dspl1236/CerberusCAN/(commit log)

2026-06-10 Initial scaffold: Cerberus — Teensy 4.1 tri-CAN OBD interface for VAG
    MVP firmware (Head 1 @ 500k ISO-TP/UDS bridge over USB serial), three-heads design + OBD pinout + HS/FT transceiver guidance, PlatformIO build + CI, and a host probe that runs the cross-module 0x00BE read (Experiment 1). Heads 2/3 stubbed.
2026-06-10 Solidify firmware: multi-frame ISO-TP writes, Head 2 @ 100k, sniff mode
    - isotp_send: full multi-frame TX (first frame + flow control + consecutive
    frames, honoring block size / STmin) so UDS writes like 2E00BE (37 bytes) and
    2E04A3 work, not just <=7-byte single-frame requests
    - bring up Head 2 (CAN2 @ 100k) alongside Head 1
    - SNIFF:<bus>:<ms> passive monitor to capture the CP handshake
    - UDS:<bus>:... explicit bus routing; INFO/PING; bare TX:RX:HEX still = Head 1
    - templated ISO-TP so one code path serves both classic buses
    - docs: SN65HVD230 dual-board reality, 3.3V/USB power, CTX/CRX direction,
    conditional Head-2 transceiver (HS SN65HVD230 vs FT TJA1055T/3), CAN-FD note
    Co-Authore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
2026-06-10 docs: commit both heads to SN65HVD230
    Head 2 FT / TJA1055T-3 case demoted from a pre-purchase decision to an if-Head-2-sniffs-nothing diagnostic note. README + HARDWARE + config.h.
2026-06-11 host: add cerberus_sniff.py + cerberus_write.py
    Sniffer: passive SNIFF capture, live dump + per-ID summary; an empty comfort bus is flagged as the fault-tolerant tell. Writer: generic read-before -> confirm -> 2E -> read-back verify UDS driver with --dry-run; not a hard-coded CP recipe. README lists all three host scripts.
2026-06-12 brand: add CerberusCAN logo/avatar/favicon + light/dark README banner
    Three Cerberus heads tapping a twisted pair (CAN-H crimson / CAN-L charcoal) with bus terminators. Assets under docs/brand/: master SVG (dark-mode aware), logo light+dark PNG, hexagon avatar (svg + 64/256/512), simplified favicon (svg + 32/64, wire dropped for small sizes). README header now uses a prefers-color-scheme <picture> banner; dark variant lightens wire/terminators to #9DA7B0 for contrast. Includes a brand guide (palette + usage) in docs/brand/README.md.
2026-06-13 docs: build guide + pre-built firmware hex; banner reflects on-car validation
    Add docs/BUILD.md (BOM, wiring, flash via Teensy Loader hex OR PlatformIO, bring-up, and real-world troubleshooting from first-light on a 2013 A6 C7 - incl. the clone-board CTX/CRX mislabel that yields INFO/PING-ok-but-0-frames). Publish firmware/cerberus-can-v0.2.0-teensy41.hex (gitignore exception for firmware/*.hex). README banner now says hardware-validated on a real car; Quick start offers both flash paths + links BUILD.md. HARDWARE: strengthen the CTX/CRX swap gotcha with the on-car symptom set.
2026-06-13 docs: Head 2 / OBD 3-11 is car-dependent (gateway firewall) - honest + forward-looking
    Pins 3/11 are OEM-discretion: some VAG/Porsche models route a 2nd CAN there, but many gateway cars (incl. the C7 A6) firewall the OBD port to the diagnostic CAN only, so 3/11 is dead and Head 2 reads nothing (Ross-Tech: OBD CAN is a dedicated diagnostic bus separated from internal buses by the gateway). README/HARDWARE/example-scan now frame Head 2 as conditional with a meter-3/11 decision tree (HS=works, FT=TJA1055T/3, dead=tap an internal bus). Keeps Head 2 valid for cars that DO expose 3/11; documents the C7 finding as the example.
2026-06-17 feat(fw): v0.3.1-tp — UDS over ISO-TP (flow control) + line protocol
    Firmware brought up to the working v0.3.1-tp that the host tools target:
    - full UDS exchange on Head 1/2 (single + multi-frame, with flow control) via
    UDS:<bus>:<TX>:<RX>:<HEX> and the TXID:RXID:HEX shorthand -> OK:<resp>
    - SNIFF:<bus>:<ms> passive dump (ms=0 = until any byte), SCAN TesterPresent sweep,
    RAW one-frame send, TP background TesterPresent keep-alive, PING/INFO
    - diagnostic ERR codes (tx-fail / no-flow-control / no-response / partial)
    - UDS_TIMEOUT_MS 1500 -> 6000 (VAG gateways take ~5 s on CP DIDs like 0x00BE)
    [cerberus_config.h, main.cpp]
2026-06-17 feat(host): live-view sniffer + ISO-TP/VW TP 2.0 decoder
    - cerberus_sniff.py: live running frame counter + run-until-Ctrl-C (ms=0), every
    frame flushed to CSV as it arrives, -v firehose option, robust buffered reader.
    - cerberus_decode.py (NEW): reassemble a capture over BOTH ISO-TP and VW TP 2.0,
    label UDS/KWP services, flag the CP-relevant ones (TrainICA / 0x00BE / 0x27).
    (The Simos-Suite repo carries an integrated twin at cp_tools/can_decode.py.)
2026-06-17 docs(host): add a VIN-free sample_capture.csv to try the decoder without hardware
    128 frames sliced from a real Audi C7 capture, covering three transactions across
    both transports so cerberus_decode.py can be tried with no board:
    - J533 gateway constellation/slot read (ISO-TP, 710/77A)
    - J255 HVAC identity (EV_AirCondiBasisUDS) (ISO-TP, 746/7B0)
    - J136 seat identity over VW TP 2.0 (200/226 setup -> 300/4C6 data)
    Engine 7E0/7E8 frames (which carry the VIN) are excluded; an assert verifies no VIN
    bytes remain. Run: python host/cerberus_decode.py host/sample_capture.csv
    [sample_capture.csv]
2026-06-17 fw 0.4.0: listen-only sniff (VCI-drop fix) + ID filter + STATS + SLCAN (#3)
    * feat(fw): listen-only SNIFF (LOM) + ID filter + STATS [v0.4.0]
    - SNIFF now runs the controller in hardware LISTEN-ONLY (setBaudRate(baud, LISTEN_ONLY))
    for the duration of the sniff, restoring TX after — so it never ACKs and can't knock a
    tester (ODIS/VAS6154) off a shared bus. Fixes VCI drops while sniffing.
    - SNIFF:<bus>:<ms>[:idlo:idhi] — optional software ID accept-range to cut volume/noise and
    focus on CP traffic; DONE: now reports an `overrun:` count (dropped-frame hint).
    - STATS:<bus> — CAN error counters / fault-confinement state / ACK-CRC-FRM-STF flags
    (FlexCAN_T4 error()), to diagnose bus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
    [cerberus_config.h, main.cpp]
2026-06-17 fw v0.5.0: CANX primitive + TC1796 CAN-BSL Tier-1 toolset (Simos8.x bench read/write) (#4)
    Adds the path to bench-read/write the Simos 8.5 engine ECU (TC1796/AudoNG, e.g.
    Audi C7 3.0T 4G0907551x), which can't be programmed over in-car OBD.
    Firmware (v0.5.0-canx):
    CANX:bus:ID:HEX[:waitms] — send one classic frame in TX mode then listen waitms.
    The send-then-listen primitive SNIFF (listen-only) and RAW (send-only) lacked;
    lets the host drive low-level request/response protocols (the TC1796 CAN BSL)
    with no per-tweak reflash. Compiles clean for teensy41.
    Host (host/tc1796_bsl.py):
    Clean reimplementation of fastboatster/TC1796_CAN_BSL's Tier-1 path over Cerberus
    serial instead of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
2026-06-17 feat(fw): v0.6.0 — Head 2 always-on listen-only logger (MON), dual-head capture (#5)
    Turns Cerberus into a dual-head capture box: Head 1 stays the active VCI (UDS
    read/write/CP), and Head 2 — a SECOND SN65HVD230 tapped in parallel on OBD 6/14,
    held LISTEN_ONLY — becomes an always-on background logger. So you can DRIVE an
    active UDS/CP exchange on Head 1 and capture the unmasked wire on Head 2 at the
    same time, from one box (the whole point for capturing the CP handshake live).
    - BUS2_BAUD 100000 -> 500000; Head 2 set LISTEN_ONLY at boot (2nd tap on the diag bus).
    - New `MON:on[:idlo:idhi] | MON:off`: streams every Head-2 frame as M2:<ms>:<id>:<hex>[:OVR],
    interleaved with command re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
2026-06-18 feat(fw): v0.7.0 — ring-buffered MON logger (lossless capture under load) (#6)
    The Head-2 background logger no longer prints straight to USB (which blocked when the
    host couldn't drain, overflowing the 256-deep FlexCAN FIFO and dropping frames). Capture
    is now decoupled by a 16384-frame / 256 KB ring buffer in OCRAM (DMAMEM):
    - mon_capture() drains the FIFO into the ring — fast, never blocks (the anti-drop guarantee).
    - mon_flush() drains the ring to USB only when there's TX room — never blocks.
    - Both run in loop() AND inside the ISO-TP wait loops, so a USB stall or a long blocking
    Head-1 transaction no longer costs frames; the ring absorbs the burst and drains after.
    - If the ring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
    [cerberus_config.h, main.cpp]
2026-06-18 feat(fw): v0.8.0 — optional SSD1306 OLED status HUD (auto-detected) (#7)
    A little on-board HUD so you can eyeball Cerberus mid-capture without a laptop. When a
    MON session is live it shows total / frames-per-sec / dropped / peak; otherwise idle +
    head roles. Throttled to ~4 Hz (I2C is blocking) — never per-loop, so it can't disturb
    the MON pump or an active transaction.
    - I2C0 (pin 18 SDA / 19 SCL) @ 0x3C, SSD1306Ascii (text-only, light). Default 128x32
    (the common 0.91/0.92"); #define OLED_128x64 for a 0.96".
    - AUTO-DETECTED: the probe NAKs if no panel is wired and every OLED line is skipped, so
    the firmware runs identically with or without the display (one binary for both).
    - Adds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
    [cerberus_config.h, main.cpp]
2026-06-18 fix(fw): v0.8.1 — OLED default 128x64 + dual-address probe + yellow-band title (#8)
    Matches the common 0.96" two-colour panels (e.g. GeeekPi 128x64 yellow/blue) the user
    actually has 20+ of:
    - Default geometry -> 128x64 (was 128x32). The yellow/blue split (16 px yellow + 48 px blue
    = 64 rows) confirms it's a 128x64; the reviewer's "0x3C is a 128x32 address" conflated the
    I2C address with resolution — 0x3C is just the standard SSD1306 address for both. Adafruit's
    128x64 example @ 0x3C is the correct config.
    - Probe 0x3C then 0x3D (some boards jumper to 0x3D; many silk-print 0x78 = the 8-bit form of
    0x3C). Still NAK-safe with no panel.
    - HUD laid out for 128x64: row 0 (yellow) = "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
    [cerberus_config.h, main.cpp]
2026-06-18 feat(fw): v0.8.2 — OLED per-head VU bars + live MODE title (#9)
    Makes the little screen show data in motion:
    - Title (yellow band) now reads "CERBERUS <MODE>" instead of the version — MODE flashes the
    last command (UDS / CANX / SCAN / RAW…) and settles to MON or IDLE. set_mode() is called per
    command in handleLine. (Version still in INFO, just not cluttering the HUD.)
    - Two auto-scaled VU bars replace the static "H1 VCI H2 LOG" line:
    H1 = our command/TX activity (h1_cmd, bumped per active command)
    H2 = bus traffic the logger sees (mon_total delta)
    Each peak rises instantly and decays slowly, so the bars "breathe" with the bus regardless
    of absolute rate — no magic c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
    [cerberus_config.h, main.cpp]
2026-06-18 docs: audit README to v0.8.2 — dual-head logger, full command set, BSL/SLCAN/OLED (#10)
    The README still described a v0.2.0 single-head + 100k-comfort-sniffer tool. Brought it
    current to the actual 0.8.2 request-level VCI:
    - Head 2 is now a 2nd SN65HVD230 on the SAME OBD 6/14 bus, LISTEN-ONLY = always-on logger
    (the old "Head 2 = 100k comfort CAN on 3/11" model was dropped in v0.6.0). Heads table +
    wiring updated; added the dual-tap wiring and the "remove both term resistors" note.
    - Command list completed: + STATS, TP, RAW, CANX, MON, SLCAN (was missing 6 commands).
    - New Features section: request-level UDS, dual-head ring-buffered lossless capture, SLCAN,
    TC1796 CAN-BSL Simos8 ben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
2026-06-18 v0.9.0 EMU responder mode + full docs audit (Head 2 -> 6/14, version-less hex) (#11)
    Firmware (v0.9.0-emu):
    - New EMU module-emulation responder (Head 1): answers UDS on a chosen REQ id from a RESP id
    by request-prefix rules (EMU:on:bus:REQ:RESP / EMU:add:PREFIX:RESP / clear / off / stat).
    Reassembles multi-frame requests (sends FC), sends multi-frame responses; unmatched -> 7F
    <sid> 11. Echoes EMURX:/EMUTX: to the host. Lets Cerberus pose as a fake module to probe how
    J533 / a tester reacts — the offensive CP angle. Runs the responder in loop() alongside MON.
    Compiles clean; EMU is dormant by default (emu_on=false) so 0.9.0 boots identically to 0.8.2.
    (Boot + EMU-on-the-wire n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
2026-06-18 v0.9.1: drop TC1796 CAN-BSL bench read/write support (#12)
    The TC1796 CAN bootstrap-loader read/write was a niche bench feature that never fit
    Cerberus's "OBD VCI" identity — pulled it to keep the tool focused.
    - Removed host/tc1796_bsl.py and docs/tc1796-bsl-cerberus-port.md (preserved in git history;
    could move to Simos-Suite later if wanted).
    - CANX stays — it's a general send-then-listen primitive, not BSL-specific; reworded its
    comment + the README/command note to drop the BSL framing.
    - Scrubbed BSL from README (feature bullet, host-scripts list, roadmap incl. the Tier-2 BSL
    item) and BUILD.md status/validated lines. INFO examples -> 0.9.1.
    Roadmap: that "older/odd cars" sl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
2026-06-18 docs(hardware): finalize K-line/KWP2000 design (USB-powered, no DC-DC) (#13)
    Records the settled design for the planned K-line interface (pre-CAN VAG, KWP2000 on OBD 7):
    - Teensy stays USB-powered -> NO DC-DC. Only the K-line transceiver's line side touches the
    car's 12 V (one wire from OBD 16 + the pull-up; the bus idles at battery voltage).
    - Two chip options: L9637D (5 V logic -> Vcc from VUSB + a level shifter, Teensy isn't 5V-tolerant)
    or MC33660 (3.3 V-capable logic -> straight to the UART, no shifter — the minimal-parts route).
    - Wiring: just OBD 7 (K-line) + OBD 16 (+12 V) beyond the CAN heads, + TX/RX to a spare UART.
    K-line is fewer bus wires than CAN (one, not a pair).
    - N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
2026-06-18 docs(hardware): K-line chip options — TJA1021/TJA1421 (3.3V VIO), rule out STN1110 (#14)
    Expands the K-line chip-choice list:
    - TJA1021 / TJA1421 (NXP LIN PHY): the VIO pin gives 3.3V-native logic -> straight to the UART,
    no level shifter. Cheap/available. Caveat: the LIN TXD-dominant timeout can kill the driver
    during ISO-9141 5-baud init (VAG uses it, incl. KW1281) — verify on the datasheet; bit-bang the
    init on a side GPIO/FET if needed. Fast-init (14230) cars unaffected.
    - MC33660: dedicated K-line, 3.3V logic, no dominant-timeout caveat — cleanest for old 5-baud VAG.
    - L9637D: classic dedicated K-line but 5V -> VUSB + level shifter.
    - STN1110 / ELM327-class interpreters expl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
2026-06-18 fw(0.9.2): HEAD2 active toggle + H2TEST self-test + SLCAN auto-enter fix (#15)
    Dual-head now hardware-validated on the live car (A6 C7): Head 1 active VCI +
    Head 2 both as a 2nd active VCI and as the listen-only MON logger (read VIN +
    gateway part on each head; MON captured Head-1 traffic, 0 dropped).
    - HEAD2:active|lom — flip Head 2 between a 2nd active VCI (UDS:2/RAW:2/CANX:2/
    SCAN:2 drive it) and the listen-only logger. Boot default = listen-only.
    - H2TEST — TX-path self-test: Head 1 listens (LISTEN_ONLY) while Head 2 transmits
    a marker frame; reports head1_saw + txerr. Splits a dead head into TX-path vs
    RX-path without a meter. (Key bring-up/QC tool for assembled units.)
    - SLC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
    [cerberus_config.h, main.cpp]
2026-06-18 fw(0.9.3): SELFTEST QC command + live-sniff GUI (#16)
    SELFTEST — one-command factory/bring-up check, no car needed:
    1) CAN1 internal loopback (controller core)
    2) CAN2 internal loopback (controller core)
    3) H1->H2 wire test: Head 1 transmits, Head 2 (LISTEN_ONLY) must hear it ->
    proves both transceivers + the shared CANH/CANL link + TX/RX orientation.
    Prints PASS/FAIL per check + "UNIT OK". Catches the exact crossed/dead-transceiver
    class of fault instantly. Verified on the bench-on-car: all three PASS.
    host/cerberus_sniff_gui.py — standalone tkinter live-sniff viewer (pyserial only):
    Connect -> sends MON:on -> streams Head 2's M2 frames into a live aggregated
    grid (I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
    [cerberus_config.h, cerberus_sniff_gui.py, main.cpp]
2026-06-18 CerberusCAN 0.9.6 — modes, firmware-flash tab, dual-target 4.0/4.1, single-exe app (#17)
    * fw(0.9.6): MODE + REBOOT + board-detect + self-contained SELFTEST + 4.0/4.1 targets
    - MODE:vci|sniff|dual — one-shot head posture (vci=active+logger, sniff=BOTH
    listen-only zero-footprint, dual=two active VCIs); steady OLED title reflects it.
    - INFO now reports board=T4.0/T4.1 (compile-time), so the host flashes the right hex.
    - REBOOT — jump to the HalfKay bootloader so the host can flash (Console Update).
    - SELFTEST: H1->H2 wire check now runs Head 2 in NORMAL mode so it ACKs Head 1
    itself -> self-contained (no external ACKer needed); clearer "needs a terminated
    bus + node" message when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
    [cerberus_config.h, cerberus_console.py, main.cpp]
2026-06-19 docs(readme): bring up to 0.9.6 — modes, Console app, 4.0/4.1, ODIS-CP capture (#18)
    - Status -> v0.9.6: dual-head hardware-validated on the A6 C7; logged a live ODIS
    Component-Protection session; builds for Teensy 4.0 AND 4.1; ships the desktop app.
    - New "Desktop app — CerberusConsole" section (Sniff / Diagnostics / Firmware tabs +
    single-.exe build).
    - Features: MODE (vci/sniff/dual, zero-footprint sniff), SELFTEST, REBOOT, 4.0/4.1.
    - Flash: one-click via the app + dual-target pio targets.
    - Host protocol: added MODE/HEAD2/H2TEST/SELFTEST/REBOOT + board= in INFO.
    - Host scripts: cerberus_console.py is the app to start with; sniff_gui superseded.
    - Roadmap: checked off modes/SELFTE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
2026-06-19 fw(0.9.7): Head 3 -> K-line / KWP2000 for pre-CAN VAG (bench-untested) (#19)
    K-line is a single-wire 12V UART bus (OBD pin 7), NOT CAN — so Head 3 moves off the
    CAN3 spare onto Serial2 (RX 7 / TX 8) through a K-line transceiver (TJA1021 et al).
    New `KWP` command:
    KWP:fast[:tgt] ISO 14230 fast init (25ms low/high -> StartCommunication 0x81)
    KWP:slow:<addr> 5-baud slow init (bit-bang the address @5 baud)
    KWP:<hex> framed request [0x80|len][tgt][F1][data][cksum] -> raw response (host parses)
    KWP:raw:<hex> send raw bytes, return raw response
    KWP:off close
    Half-duplex echo is swallowed on every send.
    Builds clean for both teensy40/teensy41. **BENCH-UN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
2026-06-19 fw(0.9.8): correct KWP2000 framing/init — validated against KWPBridge (#20)
    Cross-checked the bench-untested K-line driver against dspl1236/KWPBridge (tested on
    real cars) and fixed real bugs:
    - Frame format was wrong: used [0x80|len][tgt][F1][data][cks]; correct ISO 14230 is
    [0x80][tgt][0xF1][len][sid+data][cksum] — fmt is constant 0x80, length is a SEPARATE
    byte (not packed into the format byte).
    - Target address 0x10 -> 0x01 (engine ECU, per KWPBridge logical addressing).
    - Fast init: now the line-wiggle + 300ms sync wait only (no premature 0x81); the host
    sends the session itself (KWP:1089 for ME7 = startDiagnosticSession 0x89, or KWP:81).
    - Response now stripped to the payload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
    [cerberus_config.h, main.cpp]
2026-06-19 feat(host): DIDB + K-line DTC decode (Phase 0 of the KWPBridge port) (#21)
    Phase 0 of the KWPBridge -> Cerberus port (a deep multi-agent study of dspl1236/KWPBridge
    produced the plan). Pure host-side data + glue, no firmware footprint.
    - host/didb/ — the VAG Diagnostic Information Database ported verbatim from KWPBridge:
    dtc_descriptions.json (4,817 fault-location descriptions), modules.json (89 ECU
    addresses), and the stdlib-only lazy-singleton loader. + CREDITS.md (dealer-derived
    provenance; same data already public in KWPBridge).
    - host/kline_decode.py — fault_line()/fault_text()/vag_code()/module() over the DIDB.
    KEY DISTINCTION (verified in source): this decodes the **K-lin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
2026-06-19 feat(console): CANBUS/K-Line/Firmware pages + SAE J2012 DTC text (dual decode) (#22)
    Restructured the Console around Cerberus's heads (robust yet simple):
    - CANBUS (Heads 1-2): sub-tabs Sniff (passive logger + record) + Diagnostics (UDS:
    VIN/Part, Read/Clear DTCs) — DTCs now annotated with SAE J2012 English text.
    - K-Line (Head 3): KWP2000/KW1281 page — fast/5-baud init, session 10 89, Read ECU-ID,
    Read/Clear faults decoded via the VAG DIDB, per module address. Banner: needs the
    transceiver, bench-untested.
    - Firmware: unchanged (running vs bundled, one-click flash).
    Mode follows the active view (Sniff -> MODE:sniff; else MODE:vci); nested-notebook tab
    handling; everything preserve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
2026-06-19 fw(0.9.9): KWP baud param + KW1281 byte-engine; complete SAE DTC decode (FTB) (#23)
    Roadmap Phase 2 + 3 (firmware) + the FTB gap closed:
    - Phase 2: KWP K-line baud is now a runtime param (KWP:baud:<n>) — 10400 default, 9600
    for M232/AAN ECUs. Used by all K-line init paths.
    - Phase 3: KW1281 byte-engine (K81 cmd) — the OLD VAG block protocol for pre-CAN cars.
    Implemented fresh (NOT copied from KWPBridge, which stubs the ACK): 5-baud init +
    sync/keybyte handshake, the per-byte complement-ACK loop (must be on-Teensy — USB
    round-trip too slow), block framing [len][counter][title][data][0x03] with the shared
    auto-incrementing counter, ETX not acked. Verbs: K81:init/read/ack/block/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
    [cerberus_config.h, main.cpp, sae_decode.py]
2026-06-19 feat(console): K-Line page — KW1281 + live measuring blocks (roadmap Phase 4) (#24)
    Finishes the host side of the K-line roadmap:
    - Ported formula.py from KWPBridge (stdlib-only) — measuring-block cell scaling
    ([formula][A][B] -> RPM/°C/V/etc, raw fallback for unknown formula bytes).
    - K-Line page gains: a "Measuring group" reader (KWP2000 0x21 or KW1281 0x29 ->
    formula-decoded cells) and KW1281 Init / Read-block buttons (K81 verbs). Read-MB
    dispatches by the last-inited protocol (kwp vs kw1281).
    - Protocol tracked per init; KW1281 0xE7 measuring-value blocks decoded via the same
    formula path; faults still via the VAG DIDB.
    Implementable roadmap now complete (Phases 0-4); only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
2026-06-19 feat: product line — Orthrus (4.0) / Cerberus (4.1), one codebase (0.9.10) (#25)
    Names the two build targets as a product family (hounds of Typhon & Echidna):
    - Orthrus = Teensy 4.0, 2 heads (KWP + CAN) — compact, ~1995-2018 eras.
    - Cerberus = Teensy 4.1, 3 heads (KWP + CAN + DoIP) — flagship, every era.
    DoIP is the only differentiator and it's board-justified (the 4.0 has no Ethernet),
    so it's a compile flag (#if ARDUINO_TEENSY41), not a fork. ONE repo, one Console.
    - INFO now reports `product=Cerberus|Orthrus` (by board macro) alongside `board=`.
    - Console parses product= and titles itself accordingly ("Orthrus Console v0.9.10 —
    T4.0 fw 0.9.10"). One app serves both SKUs, in lo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
2026-06-19 feat(console): blank-board flash picker (4.0/4.1) for never-flashed Teensys (#26)
    A board that has run our firmware self-identifies via INFO (board=T4.0/T4.1) and
    flashes the correct hex with zero input — unchanged. The gap was a brand-new,
    never-flashed Teensy: 4.0 and 4.1 share the IMXRT1062 MCU and bootloader chip, so
    the model can't be auto-detected (and a blank board doesn't enumerate our serial,
    so you can't even "connect" to it).
    - Firmware tab now has a "Blank board" combobox, enabled ONLY when detection returns
    board=? (auto-detected boards keep it disabled — no way to mis-pick).
    - Flash gains a manual path: when undetected, use the picked model, skip the
    reboot-over-serial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
    [cerberus_console.py]
2026-06-19 docs: DoIP "sniff" = own-session pcap; + blank-board USB probe (#27)
    DoIP capture model decided. CAN sniff works because CAN is a shared bus; Ethernet
    is switched, so a single-PHY 4.1 can't passively hear a 3rd-party tester↔gateway
    session. The DoIP head's "sniff" is therefore own-session capture: as active tester
    or ECU emulator it logs its own frames to a .pcap (Wireshark DoIP dissector). An
    in-line DoIP tap (2 bridged interfaces / passive copper tap / SPAN, full-duplex
    wants 2 capture streams) is parked as a later external-hardware project.
    - docs/PRODUCT-LINE.md: new "DoIP capture" section + status note.
    - host/detect_teensy.py: pyserial USB-descriptor dump to empirically test whether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
2026-06-19 feat(host): DoIP (ISO 13400-2) capture decoder scaffold (#28)
    Offline-testable parser for the (unbuilt) DoIP head's own-session pcap capture:
    pcap -> peel Ethernet/IP/TCP-UDP -> filter port 13400 -> DoIP 8-byte header
    + payload -> hand UDS payloads to the existing CAN-side sae_decode.
    - Pure stdlib (no dpkt/Scapy) to keep the Console pyserial-only.
    - libpcap reader + writer (EN10MB, us/ns magic), IPv4 + VLAN peel.
    - ISO 13400-2 payload-type table; routing-activation, vehicle-announcement,
    and diagnostic-message (0x8001) decoders; diag pos/neg ack.
    - UDS (ISO 14229) SID + NRC names; DTCs reuse sae_decode (DoIP is just transport
    over the same UDS we decode for CAN — "branch by trans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
2026-06-19 docs: mark esp32 BLE bridge as archived/superseded in Related
2026-06-19 feat(fw): KWP:passthrough — transparent dumb-KKL-cable mode for NefMoto (0.9.11) (#30)
    NefMoto (and similar) want a transparent FTDI/CH340 K-line cable and own the
    KWP2000/KW1281 framing + init themselves; Cerberus's K-line head was the opposite
    (smart, firmware-framed). This adds a raw byte bridge so Cerberus can serve them.
    - `KWP:passthrough[:baud]` opens K-line at baud (10400 default) and enters a
    transparent loop: USB-serial <-> K-line, 1:1, no framing, no echo-suppression
    (the host sees the bus raw, like a real single-wire KKL cable). Reset to exit.
    - Bench-untested (no transceiver yet). Targets fast-init ECUs via NefMoto's generic
    COM-port path. KNOWN GAP: 5-baud slow-init /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
    [cerberus_config.h, cerberus_console.py, main.cpp]
2026-06-19 fix(console): PlatformIO upload fallback when teensy_loader_cli is absent (console 0.9.12)
    Running the .py from source has no teensy_loader_cli (it's only bundled into the
    .exe; PlatformIO ships teensy_post_compile, not the CLI). Flash now falls back to
    `platformio run -e teensyNN -t upload` from the repo root when the CLI isn't found,
    so the Flash button works from source. find_pio()/find_repo_root() added.
    [cerberus_console.py]
2026-06-19 ci: build CerberusConsole.exe on release tag, keep last 5 (#31)
    GitHub Actions (windows-latest): compiles teensy_loader_cli (native HID, no libusb)
    so the .exe ships a self-contained flasher, runs build_exe.bat (bundles both hexes +
    didb/saedb), and publishes the single-file exe as a Release.
    - Trigger: push a `console-v*` / `v*` tag, or the "Run workflow" button (releases the
    current CONSOLE_VERSION).
    - Retention: prunes to the newest KEEP_RELEASES (5) `console-v*` releases + their tags.
2026-06-19 ci: force CC=gcc for teensy_loader_cli (MINGW64 has ddk/hidsdi.h; bare cc=MSYS gcc lacks it)
2026-06-19 ci: tolerate teensy_loader_cli license filename variance
2026-06-19 feat: dual USB serial — always-dumb K-line KKL port for NefMoto (0.9.13) (#33)
    The board now enumerates as TWO CDC ports (USB_DUAL_SERIAL): the smart command/CAN
    port (our Console) + an always-transparent K-line cable on SerialUSB1. Tools that own
    the protocol (NefMoto, VCDS-dumb) just open the 2nd COM port — no mode to flip, no
    handoff, no replug. Realizes the "K-line dumb by default, smart available" design.
    Firmware:
    - platformio.ini: -D USB_DUAL_SERIAL.
    - kline_bridge(): raw SerialUSB1<->Serial2 pump, gated on the 2nd port being open (DTR);
    non-blocking writes (availableForWrite) so a slow K-line drain never stalls loop()/CAN.
    No buffer needed — K-line is ~10.4k half-duplex, U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
    [cerberus_config.h, cerberus_console.py, main.cpp]
2026-06-19 feat(fw): brand USB descriptor — CerberusCAN (4.1) / Orthrus (4.0) (0.9.14) (#34)
    Overrides the Teensy core's WEAK usb_string_product_name / usb_string_manufacturer_name
    with strong defs in src/usb_strings.c (PJRC's usb_names.h mechanism) — no framework
    edits, CI-safe, no global side effects. iProduct = CerberusCAN / Orthrus by board;
    iManufacturer = dspl1236. Verified both strings baked into the .elf.
    Scope note (honest): this sets the USB *descriptor* strings — shown by descriptor-aware
    tools (our Console/pyserial, USBView, IDE port menus, the "Bus reported device
    description" in Device Manager Details). The top-line Windows friendly name
    ("USB Serial Device (COMx)") is set by the i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
2026-06-19 fix(console): show raw K-line COM passively (no button/trigger) (console 0.9.15)
    The raw K-line port is transparent from power-on — there was never anything to 'trigger'.
    Replaced the 'Raw K-line port' button with an auto-updating label that just shows which
    COM is the dumb cable (the board's 2nd CDC, matched by USB serial) once connected. Point
    NefMoto there; no click, no mode to set.
    [cerberus_console.py]
2026-06-19 docs: accuracy audit — sync to 0.9.14/0.9.15 (dual-serial, NefMoto, MIT, CI releases)
    Brings the docs in line with the current state after this round of work:
    - README Status: v0.9.6 -> fw 0.9.14 / Console 0.9.15; adds dual-USB-serial (the
    always-dumb K-line port for NefMoto), the CI-built .exe on Releases, MIT; keeps the
    honest bench-untested / write-CP-experimental caveats.
    - README Console/Flash: the 2nd-COM NefMoto port, blank-board picker, PlatformIO-upload
    fallback, and "download the prebuilt .exe from Releases".
    - docs/BUILD.md: enumerates as TWO ports (product "CerberusCAN"/"Orthrus"); INFO example
    refreshed (0.9.14 + board=/product=/kline2=raw); GPLv3 footer -> MIT.
    - host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
2026-06-19 docs: accuracy audit — sync to 0.9.14/0.9.15 (dual-serial, NefMoto, MIT, CI releases)
2026-06-19 fix(console): probe-walk ports on connect — robust dual-serial port pick (0.9.16)
    The frozen .exe was landing on the raw K-line CDC and timing out: PyInstaller often
    blanks pyserial's serial_number, so the serial-number-based auto-hop never fired. Now
    connect PROBES — try a port, and if no INFO reply within its window, walk to the next
    Teensy (VID 0x16C0) port until one answers. No serial_number dependency; bounded by a
    tried-ports set so it can't ping-pong. _default_port + the raw-port label also fall back
    to VID matching.
    [cerberus_console.py]
2026-06-19 fix(console): probe-walk ports on connect — robust dual-serial port pick (0.9.16)
    The frozen .exe was landing on the raw K-line CDC and timing out: PyInstaller often blanks
    pyserial's serial_number, so the serial-number-based auto-hop never fired. Now connect PROBES:
    try a port, and if no INFO reply within its window, walk to the next Teensy (VID 0x16C0) port
    until one answers. No serial_number dependency; bounded by tried-ports so it can't ping-pong.
    _default_port + the raw-port label also fall back to VID matching.
2026-06-19 fix(console): synchronous INFO probe to pick the smart port (0.9.17)
    The 0.9.16 timed auto-hop still raced in the frozen exe — the 2.2s check fired before
    the async read-loop delivered INFO, so it bounced off the good Teensy port and walked
    all the way to COM1. Replaced it with a SYNCHRONOUS probe: _probe_port() opens a port,
    sends INFO, and reads directly for "CERBERUS:" (no async/queue timing). _connect_smart()
    probes the selected port first, then the other Teensy (VID 0x16C0) ports, and connects
    to the first that answers — deterministic, frozen-exe-safe. Removed the timed
    _verify_smart_port hop entirely.
    [cerberus_console.py]
2026-06-19 fix(console): frozen-exe fw/board detection — log redirect + probe hand-off (0.9.18)
    The exe connected but never showed fw/board: --windowed PyInstaller has sys.stdout/stderr
    == None, so an uncaught exception in the background READ-LOOP thread silently killed it,
    and the async INFO never arrived (the synchronous probe worked, which is why connect did).
    Three fixes:
    - _setup_frozen_logging(): redirect stdout/stderr to %TEMP%\CerberusConsole.log when frozen,
    so a stray print/traceback can't kill a thread (and errors are finally visible).
    - Read loop: wrap line-parsing in try/except + traceback (never dies silently).
    - Probe hand-off: _probe_port returns the OPEN port + its INFO line; _conn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
    [cerberus_console.py]
2026-06-19 fix(console): stop INFO timeout from clobbering detection + Rescan button (0.9.19)
    THE bug (seen in the exe): the probe set fw/board correctly, then the on-connect INFO
    re-query timed out (2s too short in the frozen exe) and _on_info("(timeout)") RESET the
    fields to "?". The manual INFO button worked because it used an 8s timeout + a different
    callback. Fixes:
    - _on_info() now IGNORES any non-"CERBERUS:" reply (timeouts/junk) instead of wiping
    fw/board — the real root cause.
    - on-connect INFO timeout 2s -> 6s.
    - INFO button now also refreshes the fw/board fields (manual re-detect).
    - NEW: "Rescan" button next to the port dropdown — re-enumerates COM ports for a board
    plugged in after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
    [cerberus_console.py]
2026-06-19 feat(host): detect_teensy now scans ALL PJRC USB devices, not just COM ports
    A Teensy out of the box runs PJRC's factory program and enumerates as a HID device
    (no COM port); in flash mode it's the HalfKay HID bootloader — neither shows in a
    serial-port scan, which is why a new board "only showed COM1". Now it also queries
    Windows' full USB device list by VID 0x16C0 and decodes the PID: 0x048B Dual Serial
    (our firmware), 0x0478 bootloader, 0x0486 factory HID, etc. — so you can see a board
    in any state.
2026-06-20 feat(console): "Detect new/blank board" — find + flash a Teensy that isn't a COM port (0.9.20)
    A fresh Teensy (factory HID) or one in bootloader mode isn't a serial port, so the Console
    couldn't see it — you couldn't tell it was there to flash. New button scans ALL PJRC USB
    devices (Get-PnpDevice, VID 16C0, CREATE_NO_WINDOW so no console flashes) and reports state:
    - 0x048B Dual Serial -> "Cerberus present, click Connect"
    - 0x0478 bootloader -> "flash mode, pick board + Flash"
    - other HID (0x0486) -> "blank/factory Teensy, pick board + Flash, press PROGRAM"
    The existing manual flash path (teensy_loader_cli -w / pio upload, waits for the button)
    does the actual write — this just mak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
2026-06-20 fix(console): no popup cmd window on flash + loud "press PROGRAM" prompt (0.9.21)
    Flashing a blank board from the windowed exe spawned a blank console window (the captured
    teensy_loader_cli/pio child) that just sat there until you pressed PROGRAM, with no text —
    confusing. Now:
    - subprocess.run uses CREATE_NO_WINDOW on Windows -> no popup console.
    - On the manual/blank-board path, the Console itself shows a loud ">>> PRESS the white
    PROGRAM button on the Teensy to flash <<<" line + a status-bar prompt, so you know exactly
    what to do (and you're looking at the Console, not a stray window).
    [cerberus_console.py]
2026-06-20 docs: roadmap + reserve GPIO 2 for software-switchable CAN termination
    Bench-mode termination: one 120R across OBD 6/14 via a TS5A3157 analog switch on
    GPIO pin 2 (TERM:on|off, default OUTPUT LOW = open = car-safe). Pin 2 is free on
    both 4.0 and 4.1 (clear of CAN1 22/23, CAN2 0/1, K-line 7/8, OLED 18/19). Reserved
    in the pin map so nothing else grabs it. Interim bench option: a 120R terminator
    plug across 6/14.
2026-06-20 feat(console): "Raw TX" tab — type any firmware command, see the raw reply (0.9.22)
    A terminal to the board for custom transmits on every head, since the firmware already
    has the raw-send commands and the prefix routes to the head:
    - CAN: <TX>:<RX>:<HEX> | UDS:<bus>:... | RAW:<bus>:<ID>:<HEX> | CANX:<bus>:<ID>:<HEX>[:ms]
    - KWP: KWP:<hex> | KWP:raw:<hex> K81: read block
    - DoIP: future head (same bar)
    Command entry (+Enter) → routed through _diag → raw response logged. Built-in cheat-sheet
    of the per-head formats. Single request/response (live streams stay on the Sniff tab).
2026-06-20 docs: correct TERM termination value — TS5A3157 is 10R Ron, use 110R for ~120R
    Datasheet check: TS5A3157 ON-resistance is 10 Ohm (not ~1 Ohm). A plain 120R + 10R
    switch = 130R (~4% reflection). Fix: 110R + TS5A3157 = exactly 120R; or a 1R-class
    switch (TS5A3159) + plain 120R. Switch runs on the 5V rail (signals up to V+; 3.3V
    GPIO control is 5V-tolerant). Roadmap + pin-map note updated.
    [cerberus_config.h]
2026-06-20 docs: TERM — TS5A3157 logic is ratiometric (VIH=0.7*V+); run at 3V3 on CANL leg
    Datasheet read (D:\CP\ts5a3157.pdf): control thresholds scale with supply
    (VIH=0.7*V+, VIL=0.3*V+), and "5V tolerant" only means the IN pin survives 5V — a
    3.3V GPIO does NOT reliably read HIGH at a 5V rail (VIH=3.5V). Fix baked into the
    roadmap + pin map: run the switch on the 3V3 rail and place it on the CANL leg, so
    its node stays ~1.5-2.5V (in range) and VIH=2.3V lets the 3V3 GPIO drive it directly
    — no level shifter. Ron is 10R (not ~1R), so 110R + switch = ~120R.
    [cerberus_config.h]
2026-06-20 docs(hardware): switchable bench-termination sketch (TS5A3157 + 110R, GPIO 2)
    ASCII schematic + notes in HARDWARE.md: 110R + TS5A3157 (10R Ron) ~120R across OBD
    6/14, switch on the CANL leg, V+ on 3.3V (ratiometric VIH=2.3V → 3.3V GPIO drives it,
    no level shifter), IN=GPIO2 HIGH=terminate / LOW(default)=open=car-safe. Interim:
    120R terminator plug.
2026-06-22 docs(hardware): K-line reference wiring — bare TJA1021 + dumb-vs-smart breakouts
    Add the concrete K-line transceiver wiring to HARDWARE.md: bare TJA1021 master
    node (1k+diode master pull-up, WAKE->VBAT not a GPIO, EN->3V3, TXD pull-up), the
    logic(3.3V)-vs-HV(12V) pin-domain rule, and the dumb-vs-smart breakout buyer-beware
    (one SO8 = right; MCU+reset = wrong) with the TX->RX talker->listener wiring note.
2026-08-26 fix(sniff): drain stale mailboxes before the capture window (0.9.15)
    Every SNIFF re-inits the head (setBaudRate + enableFIFO) to enter LISTEN-ONLY, which leaves stale mailbox entries that read back as id 0 / len 0. Head 2 emitted exactly 6 phantom "RX:0:0:" lines at t=0 on every capture -- the same 6 at a 2000 ms and a 5000 ms window, which is what identifies them as drained garbage rather than bus traffic. Head 1 on the same wire reported a clean DONE:0.
    Drain what the FIFO already holds before the clock starts, bounded by both a frame count (64) and 5 ms so a busy bus can never stall the pre-drain. Rebuilds the bundled hexes for both targets.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
    [cerberus_config.h, main.cpp]
2026-08-26 fix(console): identify a board stuck in SLCAN mode instead of "not found" (0.9.23)
    SLCAN mode is auto-entered by any Lawicel-looking line (O/C/L/V/F/N, S<n>, t/T+hex) and can only be left by a board reset. A board parked there NACKs INFO with 0x07, so _connect_smart reported "No Cerberus found" -- pointing at a missing/unflashed board when the firmware is in fact fine and merely in the wrong mode.
    _probe_port now returns (None, "slcan") on a bare 0x07 reply, and _connect_smart names the port and says what to actually do: power-cycle at the board end (a powered hub or USB extender keeps 5 V on the board if only the PC end is unplugged), and do NOT reflash. Bumps CONSOLE_VERSION so CI publish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
    [cerberus_console.py]
2026-08-26 fix(sniff): SNIFF:2 must leave Head 2 listen-only, not transmitting (fw 0.9.16)
    SNIFF put a head into LISTEN-ONLY for the capture and then restored BOTH heads to TX. That is right for Head 1 (the active VCI) but wrong for Head 2, which is the always-listen-only logger: boot sets it LISTEN_ONLY at Head2.begin(), MODE:vci and the H2TEST restore both put it back that way, and HARDWARE.md promises it "never ACKs or drives".
    So any SNIFF:2 left a SECOND actively-ACKing node on the same OBD 6/14 pair as Head 1, persisting until the next reboot -- breaking the zero-footprint guarantee that makes the logger safe to run alongside ODIS/PIWIS. Restore Head 2 to LISTEN_ONLY instead.
    Found while confir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
    [cerberus_config.h, cerberus_console.py, main.cpp]
2026-08-26 feat(baud): retune a head's bitrate at runtime + fix the sniff pre-drain (fw 0.9.17)
    BAUD | BAUD:<bus>:<rate> retunes a head without a reflash. Motivation: a head moved onto another bus is usually another rate, and a head at the WRONG rate sees a perfectly silent bus -- symptom-identical to an unwired tap, which is what makes hunting a non-diagnostic bus (comfort CAN off the gateway, not present on the OBD socket at all on a gateway car) so slow. Retune and re-SNIFF instead of rebuilding per guess.
    Rates are RAM-only and revert to the cerberus_config.h defaults on reboot, so an experiment can never leave the board quietly mistuned. Each head is re-inited into ITS OWN resting mode (Head 1 ac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
    [cerberus_config.h, cerberus_console.py, main.cpp]
2026-08-26 fix(capture): share the stale-mailbox drain with MON, not just SNIFF (fw 0.9.18)
    0.9.15 and 0.9.17 both fixed the pre-drain inside do_sniff only. MON:on and MODE:sniff each do their OWN setBaudRate + enableFIFO re-init and then arm the logger immediately, so both still opened a capture with the same 6 phantom 'M2:0:0:' frames -- and worse, counted them, so MON:stat reported total=6 before a single real frame arrived.
    Caught live while arming a capture on the car: MON:on printed the phantoms right after 'OK:mon-on'. Extracted the drain into drain_stale() and called it from all three capture paths (do_sniff, MON:on, MODE:sniff) so none of them can forget it again. Verified on the car: all thr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
    [cerberus_config.h, cerberus_console.py, main.cpp]
2026-08-27 feat(mode): MODE:log -- Head 1 active VCI + Head 2 logging, in one command (fw 0.9.20)
    This posture was already reachable as MODE:vci followed by MON:on, and it is the everyday working mode: drive the bus normally while the second head records everything passively. But the ordering is a trap -- MODE:vci sets mon_on=false, so doing it the other way round, or issuing any later MODE, silently kills the logging while everything still looks fine. That misread cost real time during a capture session.
    MODE:log arms both in one shot and drains the stale mailboxes first, so the log does not open with phantom frames. MODE:sniff (BOTH heads listen-only) remains the zero-footprint option for logging so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
2026-08-27 feat(mon): MON:PORT:2 -- stream the log out the 2nd CDC, not the command port (fw 0.9.21)
    Windows opens a COM port EXCLUSIVELY, so while a host tool holds the command port no separate monitor app can open it as well. Head 2 being hardware listen-only makes the logger non-interfering on the CAN bus, but the SERIAL link was still shared: M2: lines interleave with command replies, so a host that does not demux them reads a log line where it expects OK: and appears to hang.
    MON:PORT:2 sends the log to the second USB CDC instead. Command/response stays clean on port 1, the log is a firehose on port 2, and neither side has to demux the other -- a user can watch the bus while PAG-DIAG drives it. M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
    [cerberus_config.h, cerberus_console.py, main.cpp]
2026-08-27 fix: correct the module address table + stop SCAN reporting phantoms (fw 0.9.22)
    MODULES/LABELS named the wrong module for five of eight entries, and did so on ANY VAG car -- these 11-bit diagnostic addresses are chassis-invariant, so this was wrong on the C7 the tool was built for, not only on the Porsche it grew into. 713 and 714 were swapped (ABS vs cluster), 712 was called Airbag when it is the power steering, 715 was called Climatronic when it IS the airbag, and 70E was called MMI when it is the front BCM (the head unit is 773). Corrected against live part-number reads and cross-checked with the sibling tool's validated address book; table widened from 8 to 22 modules, all offsets verif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
    [cerberus_config.h, cerberus_console.py, main.cpp]
2026-08-27 feat(console): reach the comfort-domain modules from the Diagnostics tab (console 0.9.31)
    The doors and seat memory became reachable in fw 0.9.19 but the GUI had no way to touch them -- the module picker only drove UDS over ISO-TP, which cannot reach them at all. They now sit in the SAME picker, suffixed TP2.0, because from the operator's side reading a door is the same job as reading the cluster; only the framing underneath differs, and the firmware owns that.
    _mod_target() resolves the selection to ('uds', tx, rx) or ('tp20', dest, None) and the read/clear paths pick the command accordingly. DTCs differ per transport: the CAN modules answer UDS 19 02, the comfort modules answer KWP ReadDT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
    [cerberus_console.py]
2026-08-27 fix(console): verify a flash against the board instead of trusting the exit code (0.9.32)
    The Flash button reported "OK - board restarting" purely from the flasher's return code. The Teensy tools exit 0 once they have handed the hex to the loader, NOT when the board has been programmed -- so with no board attached, or no desktop session for the GUI loader to run in, a clean success was printed over a board that was never written and may now be sitting in the bootloader with no COM port. That failure hit twice in one session and, on a sold unit, would show a green message next to a dead board.
    After a zero exit the console now waits for the board to re-enumerate, probes INFO, and compares th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
    [cerberus_console.py]
2026-08-27 fix(scan): drain the queue between ids -- the content filter alone cannot stop phantoms (fw 0.9.23)
    0.9.22 made SCAN reject frames that were not TesterPresent answers, which was necessary but not sufficient. A FUNCTIONAL address (0x700, 0x7DF) is answered by EVERY module at once, and those surplus replies are genuine 02 7E 00 answers -- identical in shape to the next id's own reply, just answers to the previous question. No content check can tell them apart.
    Verified on the bench cart, which has exactly four modules (gateway 710, front BCM 70E, cluster 714, PCM 773): 0.9.22 still reported 0x701 and 0x702 as responders, both being 0x700's replies bleeding into the following windows, and DONE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
    [cerberus_config.h, cerberus_console.py, main.cpp]
2026-08-27 fix(scan): require the paired response id -- shape and draining were both insufficient (fw 0.9.24)
    Third attempt at this, and the first two were treating symptoms. 0.9.22 rejected frames that were not TesterPresent answers; 0.9.23 drained the queue between ids. On the four-module bench cart the sweep still reported 0x701 as a responder, because replies to the FUNCTIONAL 0x700 are themselves valid TesterPresent answers and the gateway-relayed ones arrive tens of ms later -- after any drain window worth having.
    Pairing decides it arithmetically instead of by timing: a reply must come from tx+0x6A (VAG) or tx+0x08 (the legislated block). 0x701's answer would be 0x76B, so a frame from 0x77A is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
    [cerberus_config.h, cerberus_console.py, main.cpp]
2026-08-27 fix(tp20): settle before re-homing to another module (fw 0.9.25)
    TP20 re-homes the channel when dest changes, so a host can walk several comfort modules without closing by hand -- that is the documented contract. But tp20_disconnect() puts A8 on the wire and returns in microseconds, and the next channel setup went out before the old ECU had torn its side down. The new channel came up desynced and then answered ERR:tp20-timeout for every request until something issued an explicit CLOSE -- which is why a host-side retry could not rescue it: the retry met the same wedged channel.
    Measured on the car, alternating between two doors with no explicit close: 14/40 reads failed before, 1/40 after; a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
    [cerberus_config.h, cerberus_console.py, main.cpp]
2026-11-05 fix(isotp): wait for a free TX mailbox instead of dropping the frame (fw 0.9.26)
    A 514-byte TransferData to the 958 gateway's bootloader died with ERR:tx-fail in
    0.05 s -- far too fast for any ECU to have timed out, which is what gave the cause
    away as ours rather than the bus's.
    bus.write() has three outcomes and `if (!bus.write(m)) return 1;` collapsed them:
    1 -> into one of the 8 hardware TX mailboxes
    -1 -> all busy, queued in FlexCAN_T4's 16-entry software queue. NOT lost: the
    TX-complete ISR drains it in order (enableFIFO arms the MB interrupts,
    begin() enables the NVIC). The old code took this as success, correctly
    but by luck.
    0 -> mailboxes AND that q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
2026-11-05 fix(isotp): send through ONE mailbox, strictly in order (fw 0.9.27)
    0.9.26 stopped the drops. The gateway bootloader then still answered nothing to
    any message longer than 9 CAN frames, with a sharp cutoff -- 8 and 9 frames
    passed, 10 and up got ERR:no-response for the very first 36 -- while STATS said
    txfull=0 txraced=0 and the bus Error Active. Nothing was being lost, so the frames
    were arriving in the wrong ORDER.
    The cutoff is where the mailbox arithmetic says it must be, which is what rules
    out "the bootloader is too slow". There are 8 TX mailboxes (MB8..MB15: MAXMB 16,
    FIFO + filter table take MB0..MB7). The First Frame goes out alone and we then
    block in wait_fc for the module's Flow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
